dgaff/binaryclock/images/IMG_2680.jpeg

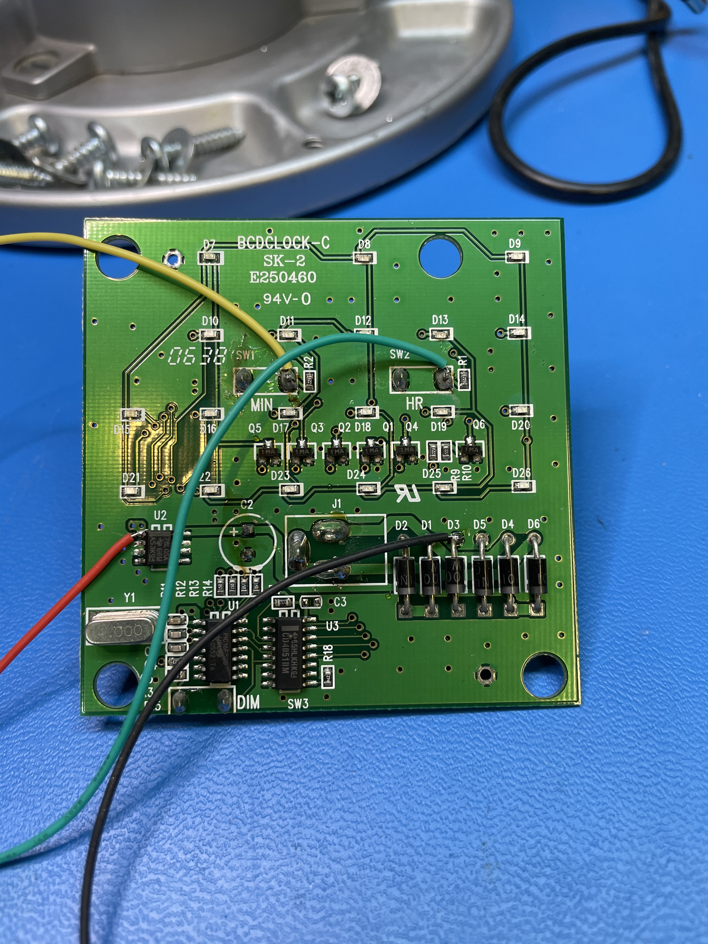
[picture p4: images/IMG_2680.jpeg]
images/IMG_2680.jpeg
