dgaff/binaryclock/images/IMG_2711.jpeg

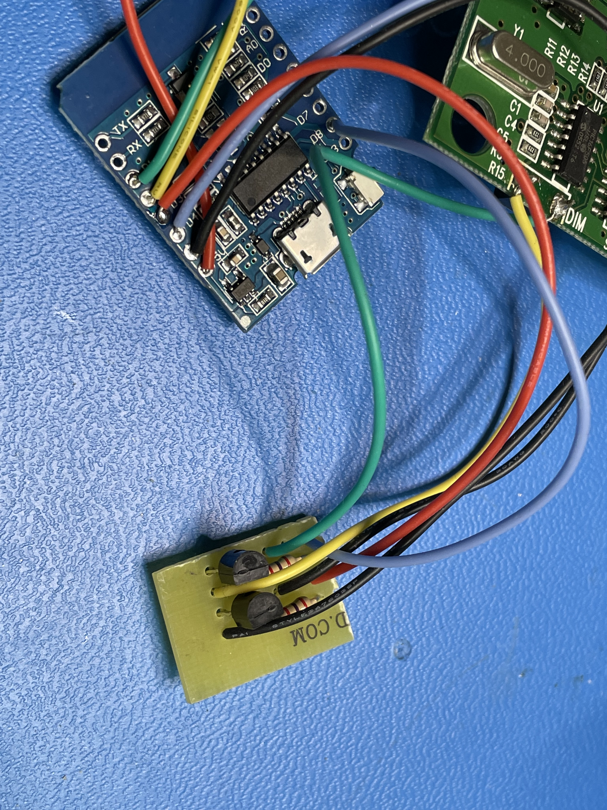
[picture p6: images/IMG_2711.jpeg]
images/IMG_2711.jpeg
