dgaff/binaryclock/images/IMG_2718.jpeg

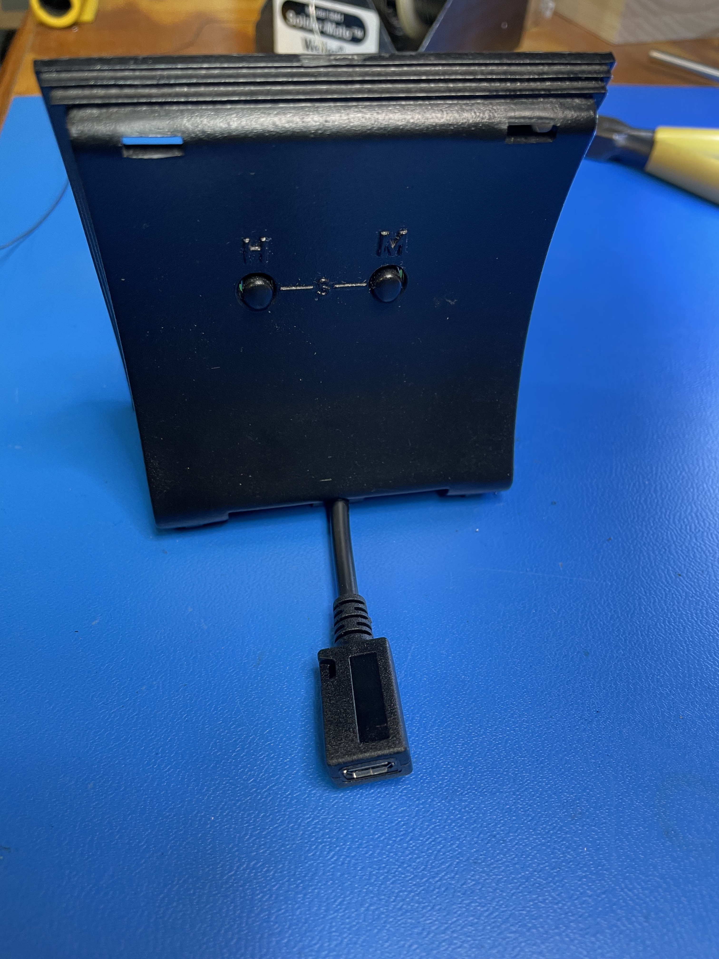
[picture p11: images/IMG_2718.jpeg]
images/IMG_2718.jpeg
